HuangHsiangTai/micro_reservoir/docs/img/schema.pptx

浮球溢位開關

10K Ω

control

100K Ω

5V

繼電器

input

output

Linkit 7697

5V

D3

地

5V

3V3

升壓模組
5V-> 12V

input

12V

電磁閥開關

p15

GND

GND

GND

GND

Linkit 7697 本身提供5V, 3.3V和GND線
