HuangHsiangTai/micro_reservoir/(commit log)

2017-10-12 get the average of the light sensor
    Maybe I don't need light sensor in the near future
2017-10-15 remove Light Sensor, add water threshold, not verified
